OliverWoehrer/Brunnen/docu/Water_Well_Watcher_Schematics.pdf

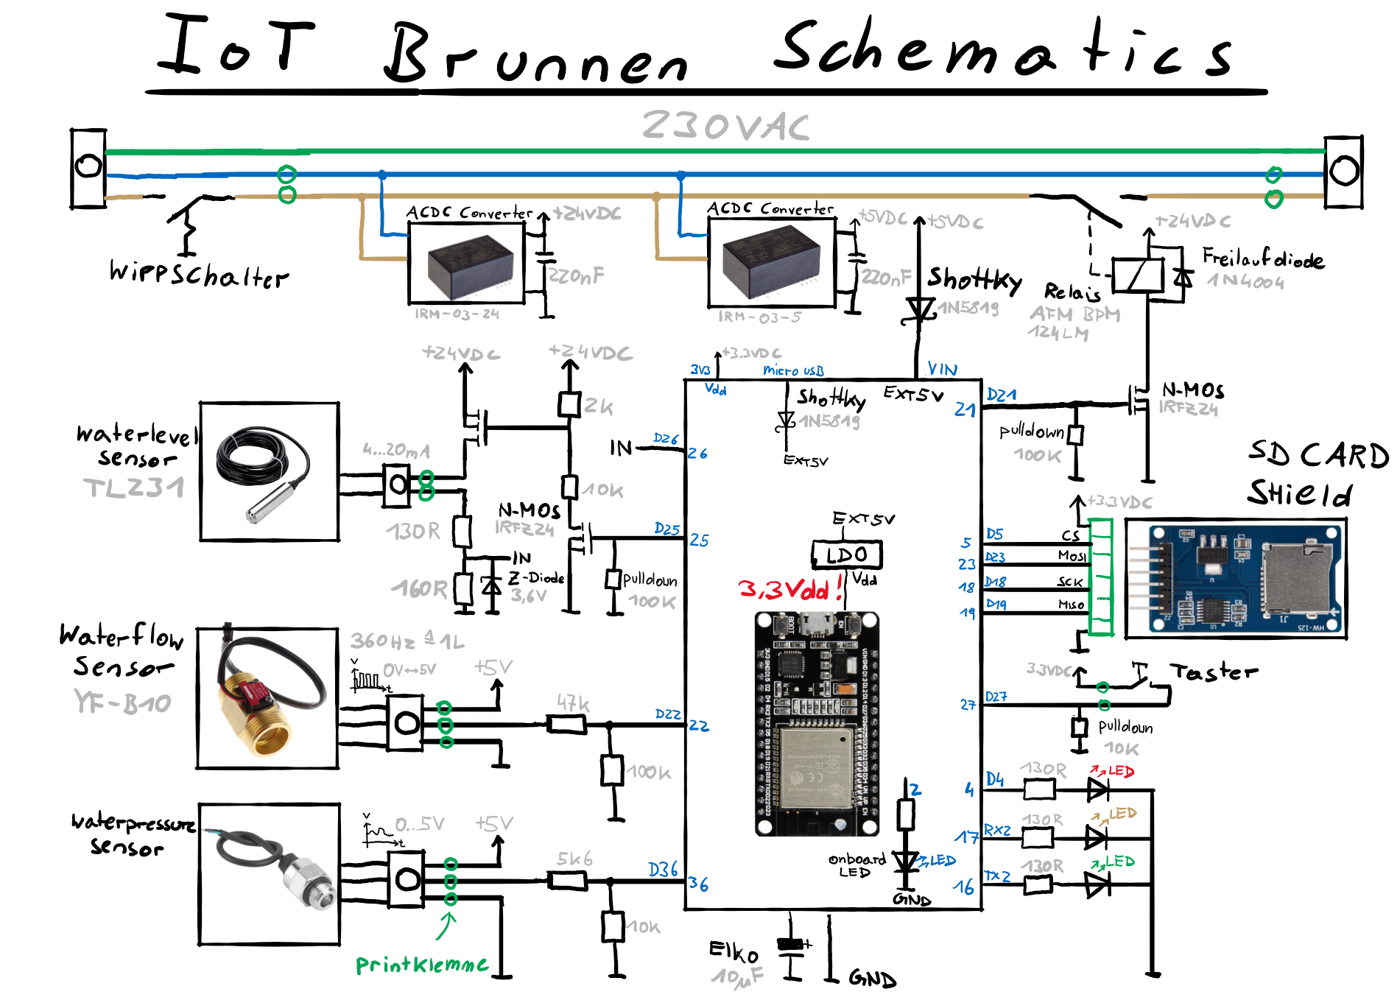
[picture p1: page 1]
