OliverWoehrer/Brunnen/(threads)

Thread 1 (2021-09-23):

Nominal Range of Pressure Sensor too small

OliverWoehrer, 2021-09-23:
After some testing it shows that the pressure can drop down to 220 Bits. Therefore the lower limit of the nominal pressure range should be adopted to 200.

Thread 7 (2023-07-04):

Remember Network

OliverWoehrer, 2023-07-04:
The device remembers last network it was connect to. This helps after rebooting to find a network quicker and not try all known networks. It the last network is not found, the device tries other options.
