OliverWoehrer/Brunnen/docu/ESP32_Core-Board_Schematics.pdf

5

4

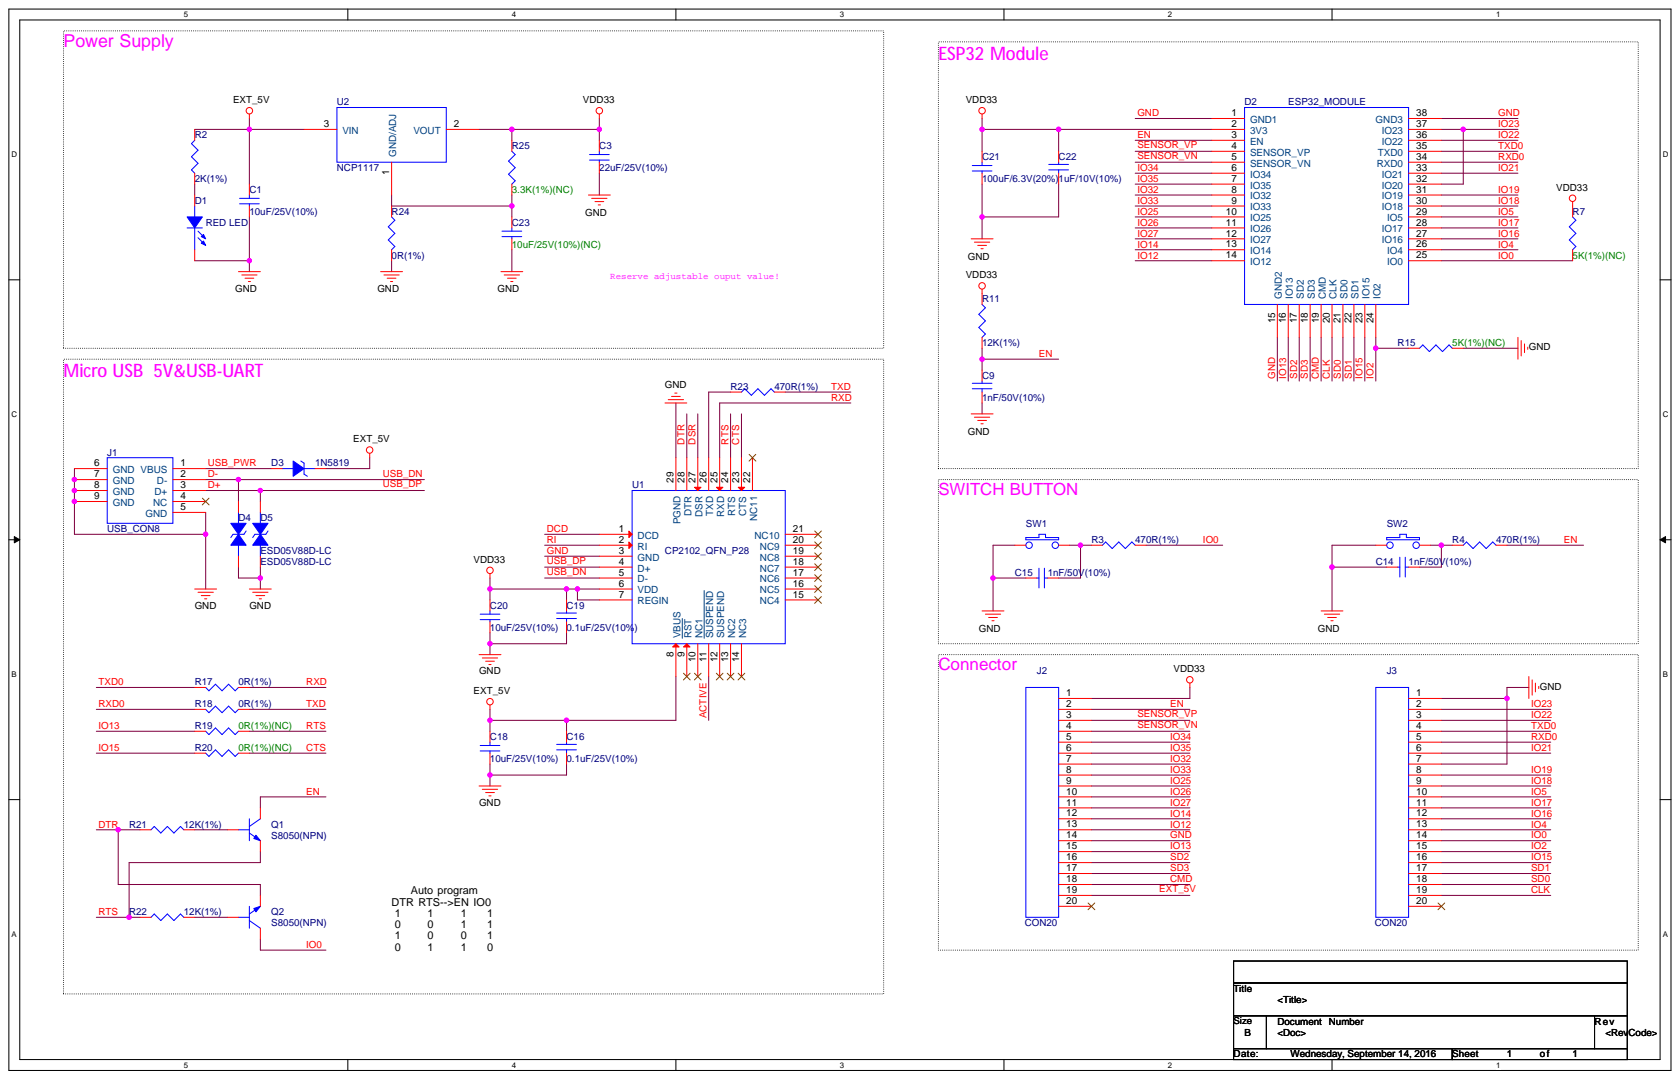
[picture p2: page 1]

Reserve adjustable ouput value!

Micro USB 5V&USB-UART

# USB Part

# Power Part

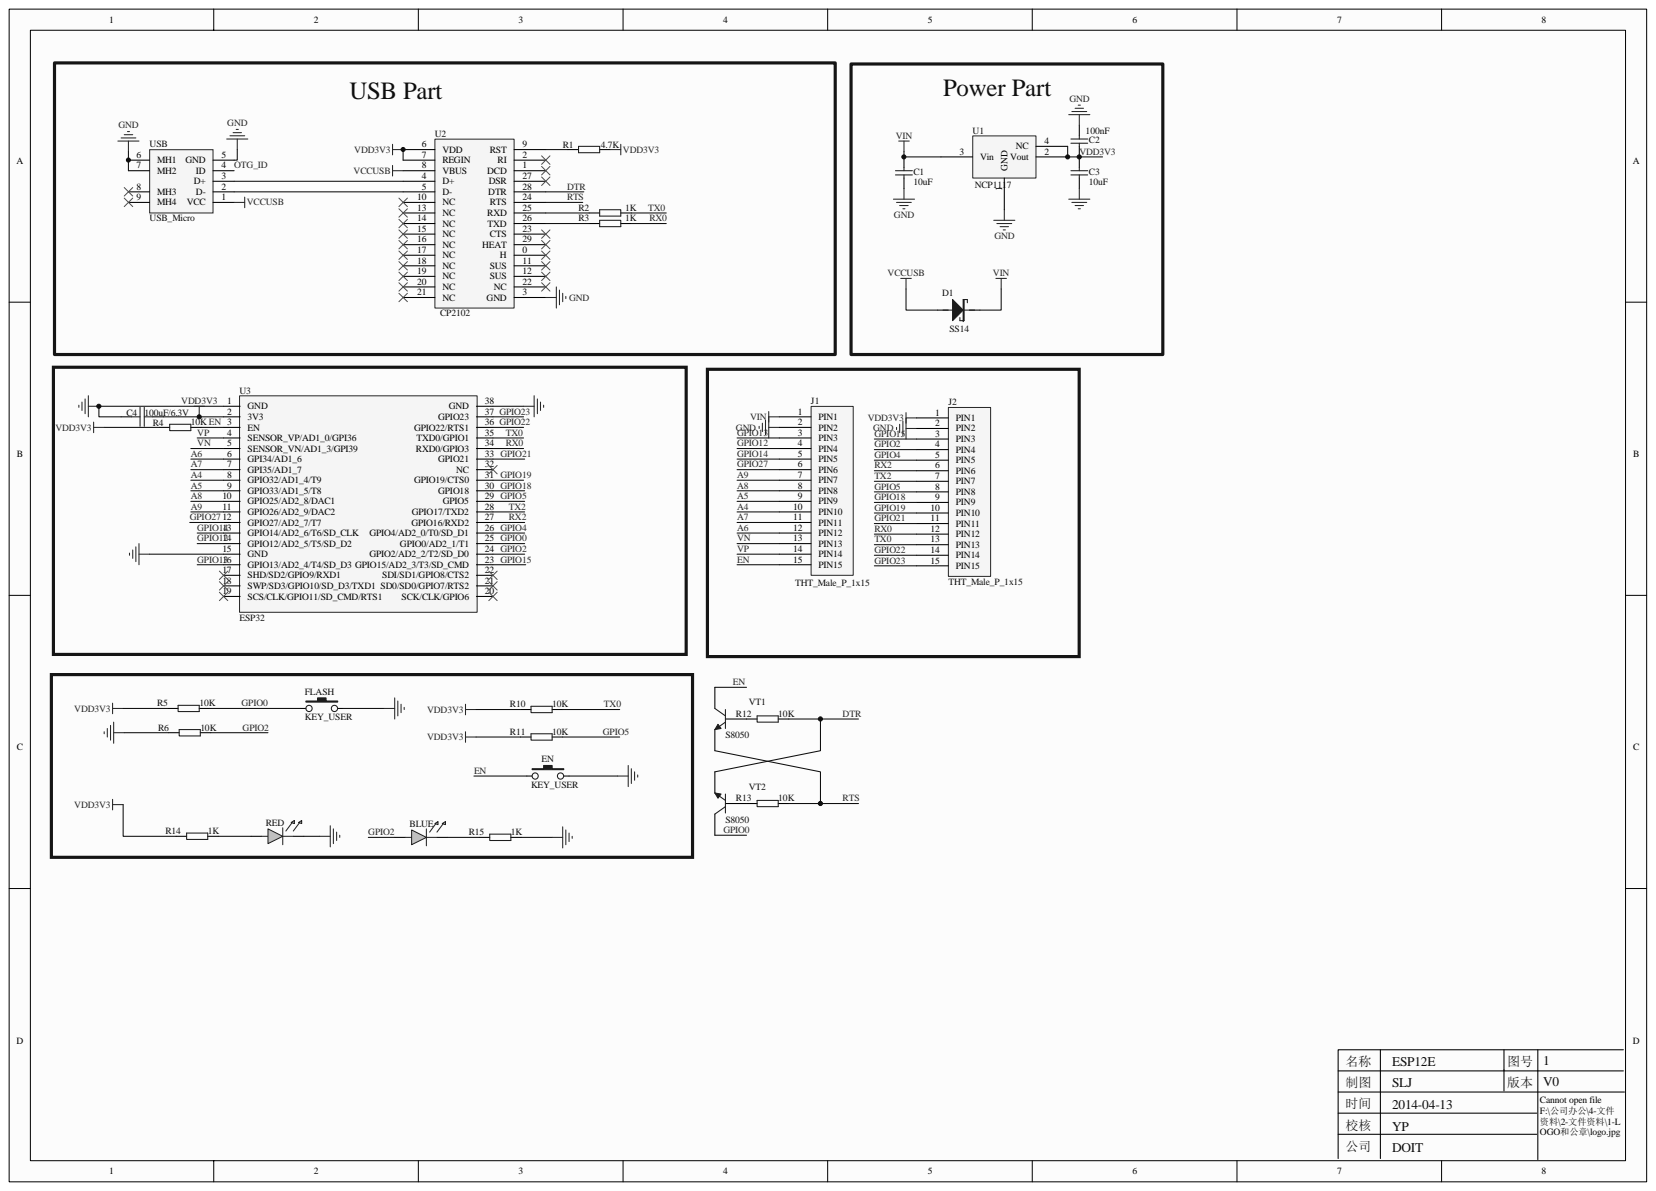
[picture p3: page 2]
