OliverWoehrer/Brunnen/docu/PCB_Mounting_v2.pdf

230V SW | WP⁺ | WP⁻ | WP~ | WL+ | WL-
5VDC | IRFZ24NPBF

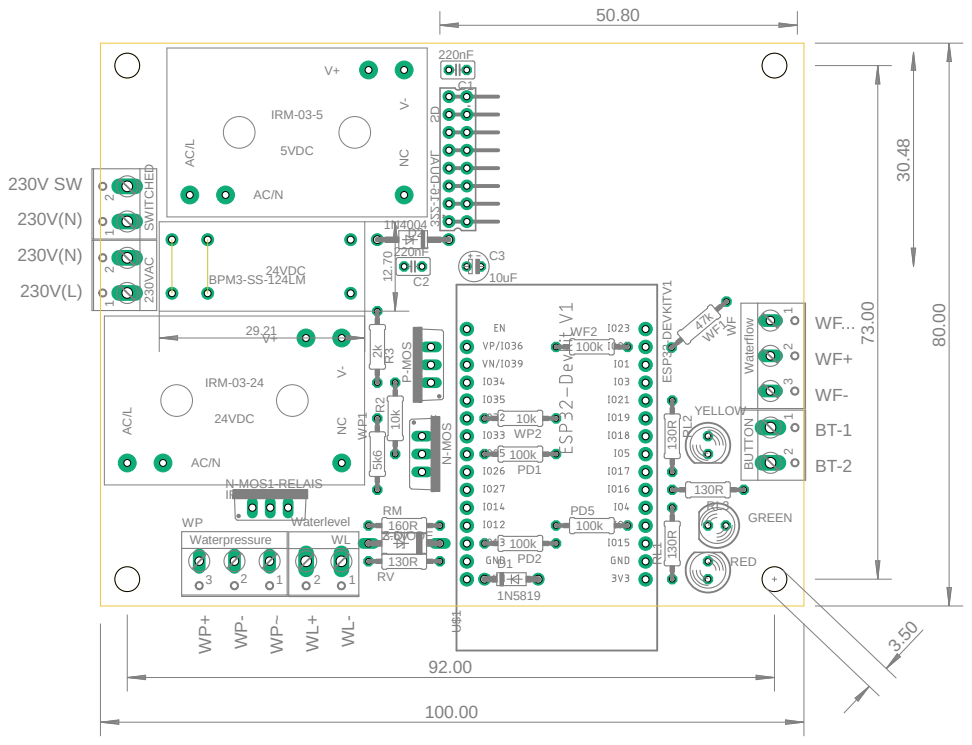
[picture p4: page 1]
GREEN; IRM-03-24; IRM-03-5; N⁻MOS; N-MOS1-RELAIS; P⁻MOS; RED RL2; BPM3-SS-124LM; WP¹; YELLOW; Z-DIODE; C2 SWITCHED 230VAC; BUTTON; 24VDC; IRFZ24NPBF; IRF9510PBF; 100k ¹⁰k 2k; 130R ¹³⁰R; ESP³²⁻DEVKITV¹; Waterlevel; Waterpressure; Waterflow

322-16-DUAL SD AC/L

1N4004
D2
