OliverWoehrer/Brunnen/edge/hardware/brunnen_v2.brd

## EAGLE design edge/hardware/brunnen_v2.brd (2021-10-18)

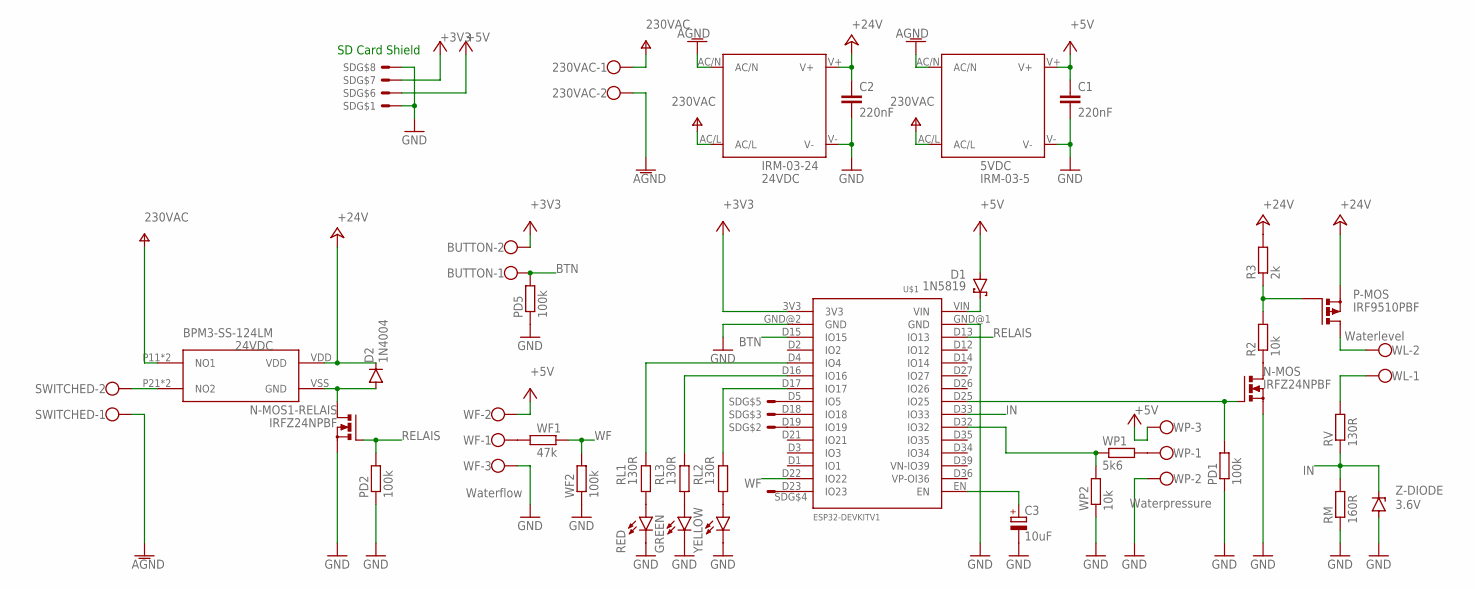
[picture p5: schematic brunnen_v2.sch]

Parts:
230VAC: W237-102
BUTTON: W237-102
C1, C2: 220nF; C025-025X050
C3: 10uF; E2-4
D1: 1N5819; DO41-7.6
D2: 1N4004; DO41-10
GREEN: LED5MM
IRM-03-5: 5VDC; IRM_03
IRM-03-24: 24VDC; IRM_03
N-MOS, N-MOS1-RELAIS: IRFZ24NPBF; TO220BV
P-MOS: IRF9510PBF; TO220BV
PD1, PD2, PD5: 100k; 0207/10
R2: 10k; 0207/10
R3: 2k; 0207/10
RED: LED5MM
RL1, RL2, RL3: 130R; 0207/10
RM: 160R; 0207/10
RV: 130R; 0207/10
SD: 322-16-DUAL
SWITCHED: W237-102
U$1: ESP32DEVKITV1; ESP32-DEVKITV1
U$2: BPM3-SS-124LM
WF: Waterflow; W237-103
WF1: 47k; 0207/10
WF2: 100k; 0207/10
WL: Waterlevel; W237-102
WP: Waterpressure; W237-103
WP1: 5k6; 0207/10
WP2: 10k; 0207/10
YELLOW: LED5MM
Z-DIODE: 3.6V; F126Z10

Connections:
+3V3: BUTTON.2, SD.13, SD.14, U$1.3V3
+5V: C1.1, D1.A, IRM-03-5.V+, SD.11, SD.12, WF.2, WP.3
+24V: C2.1, D2.C, IRM-03-24.V+, P-MOS.S, R3.2, U$2.VDD
AGND: 230VAC.2, IRM-03-5.AC/N, IRM-03-24.AC/N, SWITCHED.1
BTN: BUTTON.1, PD5.2, U$1.D15 (IO15)
GND: C1.2, C2.2, C3.-, GREEN.K (C), IRM-03-5.V-, IRM-03-24.V-, N-MOS.S, N-MOS1-RELAIS.S, PD1.1, PD2.1, PD5.1, RED.K (C), RM.1, SD.1, SD.2, SD.15, SD.16, U$1.GND@1 (GND), U$1.GND@2 (GND), WF.3, WF2.1, WP.2, WP2.1, YELLOW.K (C), Z-DIODE.A
IN: RM.2, RV.1, U$1.D33 (IO33), Z-DIODE.C
unnamed: N-MOS.G, PD1.2, U$1.D25 (IO25)
unnamed: N-MOS.D, R2.1
unnamed: P-MOS.G, R2.2, R3.1
unnamed: P-MOS.D, WL.2
unnamed: D1.C, U$1.VIN
unnamed: SWITCHED.2, U$2.P21 (NO2), U$2.P22 (NO2)
unnamed: WF.1, WF1.1
unnamed: D2.A, N-MOS1-RELAIS.D, U$2.VSS (GND)
unnamed: WP.1, WP1.2
unnamed: U$1.D32 (IO32), WP1.1, WP2.2
unnamed: RV.2, WL.1
unnamed: RED.A, RL1.1
unnamed: RL2.2, U$1.D17 (IO17)
unnamed: RL2.1, YELLOW.A
unnamed: GREEN.A, RL3.1
unnamed: RL3.2, U$1.D16 (IO16)
unnamed: RL1.2, U$1.D4 (IO4)
unnamed: SD.7, SD.8, U$1.D23 (IO23)
unnamed: C3.+, U$1.EN
unnamed: SD.5, SD.6, U$1.D18 (IO18)
unnamed: SD.9, SD.10, U$1.D5 (IO5)
unnamed: SD.3, SD.4, U$1.D19 (IO19)
RELAIS: N-MOS1-RELAIS.G, PD2.2, U$1.D13 (IO13)
V+: 230VAC.1, IRM-03-5.AC/L, IRM-03-24.AC/L, U$2.P11 (NO1), U$2.P12 (NO1)
WF: U$1.D22 (IO22), WF1.2, WF2.2

Notes on the sheet:
SD Card Shield

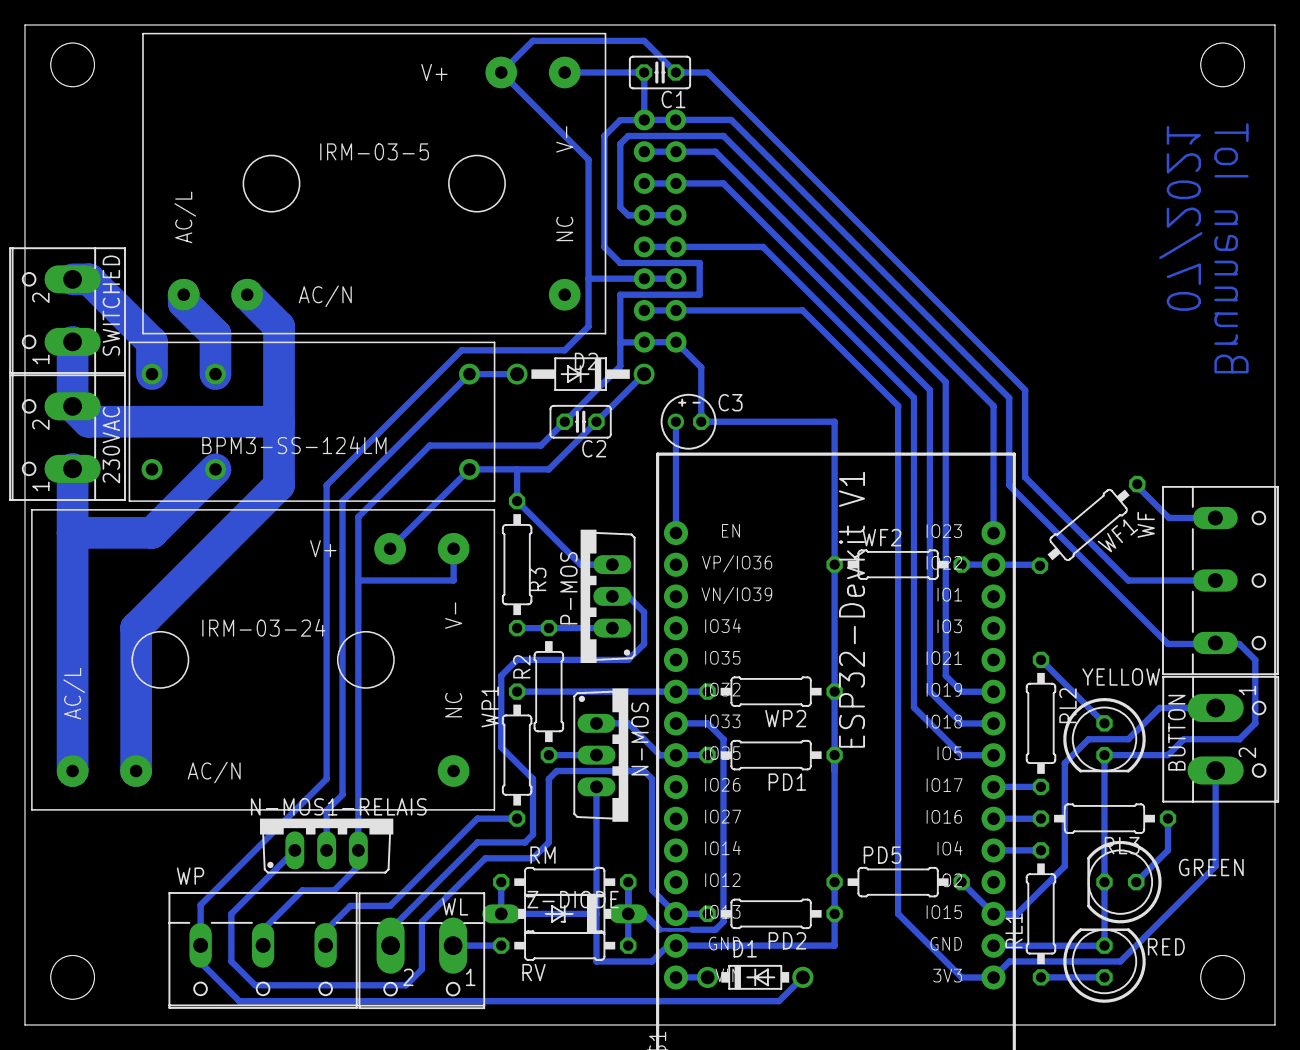
[picture p6: board brunnen_v2.brd from above]

Board: 2 copper layers, 100.0 x 80.0 mm, 37 parts (1 on the bottom side), 32 nets.
