OliverWoehrer/Brunnen/edge/src/LogFile.h

#ifndef LOG_FILE_H
#define LOG_FILE_H

#include "FileManager.h"
#include "SPIFFS.h"
#include "Output.h"
#include "TimeManager.h"

// Pin Definitions:
#define LED_RED 4

#define MAX_LOG_LENGTH 100

typedef enum {INFO, WARNING, ERROR, DEBUG} log_mode_t;

typedef struct {
    tm timestamp;
    std::string message;
    std::string tag;
} log_message_t;

class Log {
public:
    Log(const std::string& filename);
    bool begin();
    bool log(log_mode_t mode, std::string&& msg);
    bool exportLogs(std::vector<log_message_t>& logs);
    bool shrink(size_t num);
    bool clear(void);
    void acknowledge();
private:
    FileManager file;
    Output::Digital led;
    SemaphoreHandle_t semaphore;

    bool parseLogLine(const char line[], log_message_t& msg);
};

extern Log LogFile;

#endif /* LOG_FILE_H */
