OliverWoehrer/Brunnen/(commit log)

2021-10-18 changed file stucture
    [brunnen_v2.brd, brunnen_v2.sch]
2022-10-09 mail module implemented fixed bugs
    [code.cpp]
2022-12-15 added CR to newline characters for serial print
2022-12-18 added button to clear job list
2022-12-22 added functionality to clear error led and set threshold rain level
2023-03-18 merged methods for sensor sampling
2023-03-18 adjusted interrupt behavior
2023-03-23 merged esp32 schematics into on file
2023-05-04 changed button toggle behavior
2023-05-06 Revert "removed faulty return statement from sendMailTask"
    This reverts commit 899987f3ecbea785784dbc2304b22229e771466b.
    [code.cpp]
2024-08-27 renamed folder for files of on-board filesystem
2024-08-27 simple prototype
2024-09-04 basic structure of database tables (buckets)
2024-09-16 implemented support to store device access tokens in database
2024-09-16 renamed button and card macro for consisten naming
2024-09-19 implemented authentication for device api endpoints
2024-09-24 implemented new buttons, links and submits
2024-09-25 added edge case of small aggregation window
2024-10-03 added type to button element to prevent unwanted submission when used in html forms
2024-10-09 new structure of repo (moved edge related code into sub-folder)
    [brunnen_v2.brd, brunnen_v2.sch]
2024-12-04 implementation of service modules (sensors, time and files)
2024-12-08 fix string assignment: copy bytes into buffer
    [DataFile.cpp, DataFile.h]
2024-12-28 dont mount FS in constructor, fixes on strings, vector capacity and buffer sizes
    [DataFile.cpp, DataFile.h]
2024-12-28 print additional information about already connected address
2024-12-28 use newer version of ArduinoJSON
2024-12-28 fixed isues, call begin methods on both files
    [code.cpp]
2025-01-01 fixed broken store function
    [DataFile.cpp]
2025-01-01 print debug messages always (not matter the number of exported lines)
2025-01-05 added blue led to indicate sync process with visible hardware
2025-01-05 removed led as a visualization of ongoing sensor sampling
2025-01-05 fixed return type of size()
    [LogFile.cpp]
2025-01-06 log and exit early on mutex fail
    [DataFile.cpp]
2025-01-06 no success on shrinking data file is now a warning, not an error
    [code.cpp]
2025-01-18 print timestamp if available also to serial
2025-01-18 clear error led after successful sync
    [code.cpp]
2025-03-30 fix off by one error
    [code.cpp]
2025-03-30 implement auto fix for broken file
    [LogFile.cpp]
2025-04-15 filter rows with faulty timestamp
2025-05-27 remove email credentials, changed behavior on SD card fail
    [UserInterface.cpp]
2025-06-01 add endpoint for edge device to download firmware file
2025-07-25 added reboot after multiple failed synchs
    [code.cpp]
2025-07-25 implemented runtime wrapper for LED resource
2025-09-12 changed behavior of scheduler to return current state of pump
2026-05-10 added sensor data to status message
2026-05-15 fixed initial measurement period
    [code.cpp]
2026-05-15 made log message verbose to prevent spamming by measurement task
    [StateManager.cpp]
